kreiff/Cosmic_Loop/Hardware/CL_BOM.xlsx

Part | Qty | Link | Notes
Sanwa OBSF-24 Arcade Buttons (24mm) colors of your choice! | 8 | https://paradisearcadeshop.com/en/home/controls/buttons/buttons-sanwa/sanwa-obsf-24/373_blue-24mm-sanwa-obsf-pushbutton | Any arcade style momentary button is fine - Sanwa is great quality, though
5mm LED | 1 | https://www.mammothelectronics.com/products/wp7113surc-e-5mm-led-red-led
LED Bezel | 1 | https://www.mammothelectronics.com/products/4sledbz5-1
1/4" Mono Enclosed Jack | 2 | https://www.mammothelectronics.com/products/4sjk102m | You don't need to use enclosed jacks, I just prefer them. You can get a Stereo input, but Output is mono via the Shield
4S6500 Enclosure | 1 | https://www.mammothelectronics.com/products/4s6500-enclosure | Any larger hammond style enclosure will do.
10k linear Alpha Single-Gang 12mm Solder Terms | 6 | http://www.smallbear-electronics.mybigcommerce.com/alpha-single-gang-12mm-solder-terms/ | I used 12mm pots - because they are small, but depending on your enclosure you can use bigger ones. Just make sure they are 10k.
Hook-up Wire 22 guage or so | - | https://www.amazon.com/Stranded-different-colored-spools-included/dp/B00B4ZQ3L0/ | You'll probably only need like 12" of wire, but if you DIY, you probably have some
2.2k Resistor | 1 | https://www.mammothelectronics.com/collections/resistors/products/copy-of-1-4-watt-metal-film-resistor-1k-ohms-910k-ohms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 | 1% or 5% tolerance. Just current limiting for the LED.
Arduino Uno | 1 | https://www.amazon.com/gp/product/B008GRTSV6/ref=oh_aui_detailpage_o00_s00?ie=UTF8&psc=1 | Shield works with Due, Mega, and really any other Uno compatible varient
Audio Hacker Shield | 1 | https://nootropicdesign.com/store/product/audio-hacker-kit/ | Kit or assembled.
Center Positive 9V AC/DC adapter (2.1mm barrel) | 1 | https://www.amazon.com/gp/product/B06Y1LF8T5/ref=oh_aui_detailpage_o06_s00?ie=UTF8&psc=1
CR2032 Battery Holder | 1 | https://www.amazon.com/Shapenty-Plastic-Vertical-Battery-Sockets/dp/B071F3HW8J/ | You just need 1 for the project...couldn't find like a $0.25 single anywhere.
CR32 Battery | 1 | https://www.amazon.com/gp/product/B00FO9HQLS/ | same as above...
6 colorful knobs | 6 | http://www.smallbear-electronics.mybigcommerce.com/synth-pointer-2-colors/ | Pots I chose are straight shaft - just make sure you get 1/4" straight shaft if you use the alphas from Small Bear
USB Cable | 1 | https://www.amazon.com/AmazonBasics-USB-2-0-Cable-Male/dp/B00NH11KIK/ | To program the Arduino - if you already have one, you're good.
PCB Standoffs | 4 | https://www.amazon.com/Adhesive-Standoffs-Height-Offset-0-6x0-6/dp/B00QW1QMSU/ | I'm just using these to hold the PCB in place once it's in the case. Neither the Shield or Uno have any kind of mounting hardware on the input side.
Necessary Tools
Drill & bits |  |  | You need to drill the holes for the pots, arcade buttons, Jacks, USB input, etc.
Soldering Iron |  |  | For soldering connections between the buttons, pots, etc.
Solder |  |  | See above
pliers
wire stripper
wire cutters
Nice to have
24mm drill bit / hole saw | 1 | https://www.newegg.com/Product/Product.aspx?Item=9SIAEB47K21703&Tpk=9SIAEB47K21703 | The hole for the Sanwa 24mm buttons needs to be as close as possible to 24mm - the lip on the buttons is pretty shallow - 25mm is actually too big.
Graduated Drill Bit (to 24mm | 1 | https://www.amazon.com/gp/product/B01IEF4666/ | If you don't want a drill bit just for 24mm buttons, a graduated drill bit like this is a good option, but can be hard to work with. Try drilling a pilot hole first and transition to this.
Metal File Set | 1 | https://www.amazon.com/gp/product/B07FJQ9XKG/ | Great for filing burrs as you drill the larger holes. Will also come in handy if you don't have a metal saw or any other way to get square cuts for the USB and DC inlet.
Dremel w/ 1/2" cutting disk | 1 |  | A dremel tool with a small cutting disk would be great for making the USB and DC inlet holes in the enclosure - but not everyone has access to a dremel.
