kreiff/Cosmic_Loop/Comic Loop Manual (Rough).pdf

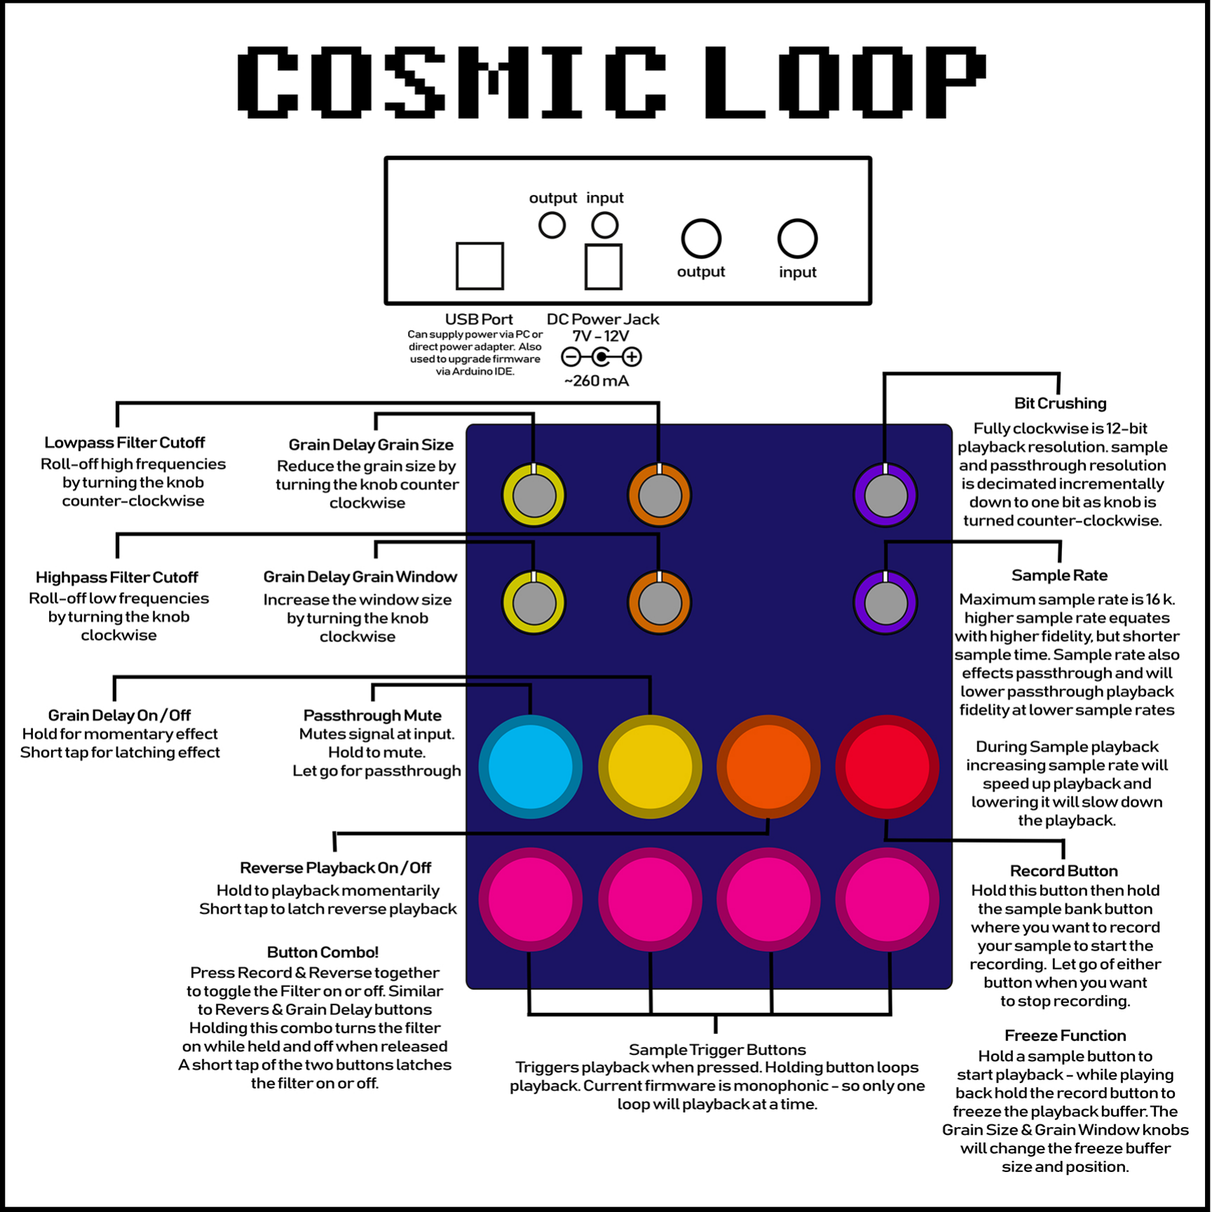
[picture p2: page 1]
