kreiff/Cosmic_Loop/Hardware/CL_Wiring_Diagram (10.21).png

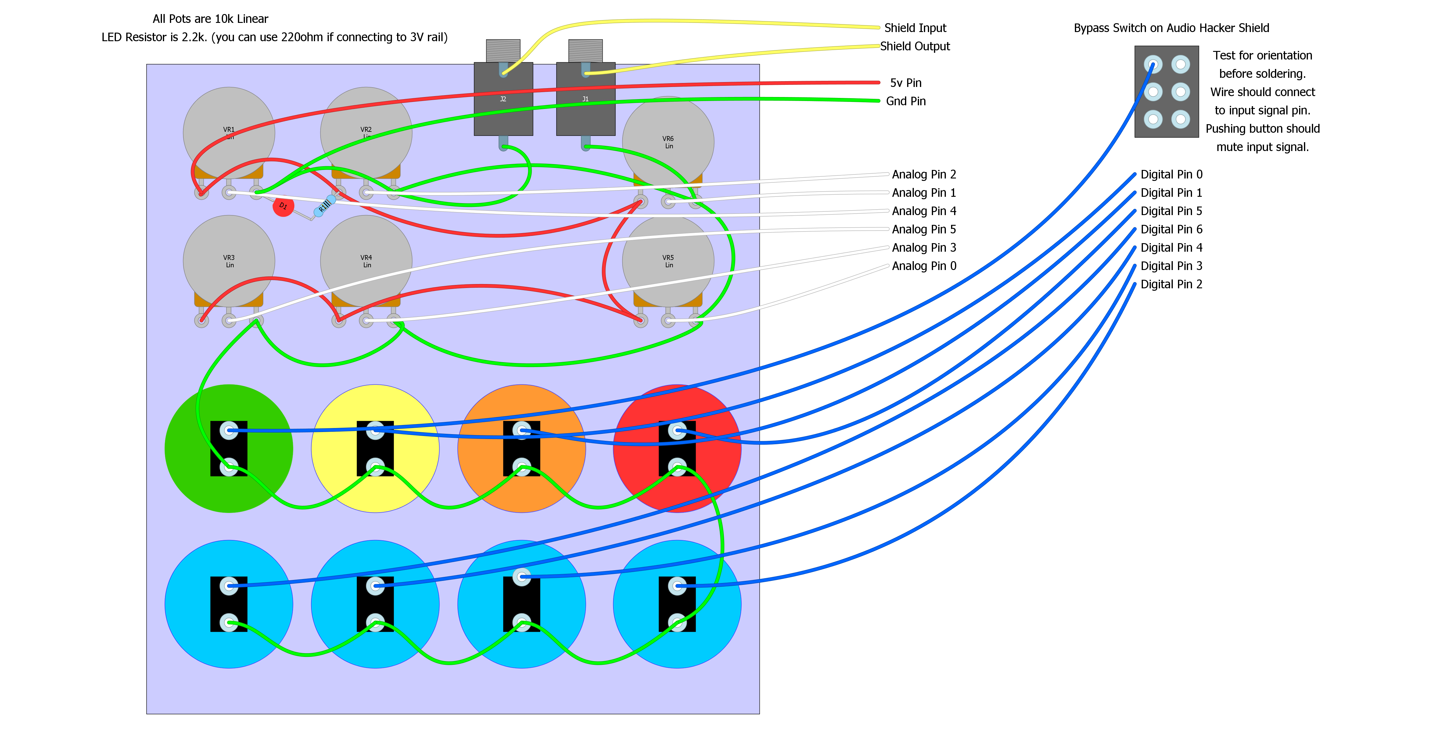
Hardware/CL_Wiring_Diagram (10.21).png
