kreiff/Cosmic_Loop/(commit log)

2018-09-30 Rename MS_speed_bit_crush.ino to Current Build/MS_speed_bit_crush.ino
2018-10-10 Reverse Button Fix, SRT Fix, lowered SRT
2018-10-13 HighPass on Reverse Added, Resonance on Dual Filter Added
2018-10-13 Fixed Reverse UX
    You can now go into reverse mode while a sample is playing by tapping (not holding) the reverse button.
2018-10-14 Updated build w/ Button State Refactor and Better Comments
2018-10-20 Rename CL_10.19_All_Feature_Build.ino to Current Build/CL_10.19_All_Feature_Build.ino
2018-10-21 Updated wiring diagram
    Added wiring for input / passthrough mute and all buttons
2018-10-21 Added Recording Threshold, New comments
    Added a recording threshold for sampling percussive sounds. You can now hold the record button and the record function will not start until the input signal reaches a level slightly above the noise floor. The noise floor for a 12bit A/D is typically around -66db, so the threshold is around -50db or so.
    Added commentary describing the hardwired passthrough mute button.
2018-10-23 BOM Added!
    [CL_BOM.xlsx]
2018-10-24 Current Build For Version 1.0
2018-10-24 Current Build Version 1.0
2018-11-03 Added Filter On/Off via combo button press
2018-11-03 BETA: Freeze Mode Added
    Noted Issue: Toggling the Filter on and off while the buffer is frozen sometimes changes the playback position.
2018-11-18 Added Updated TOP Drill template
2026-04-09 Many long overdue bug fixes
    - Fixed reverse sample implementation - putting the read buffers in the correct order for reverse playback
    - Fixed grain delay implementation - Intra-grain looping was skipped in the v1.2, but added here. Earlier implementation incorrectly advanced through the sample by 3 grains rather than just one.
    - Addressed noise issues native to the ADC by adding some gating on the passthrough symbol when the input signal is below a certain threshold. Allows for much quieter operation at 12-bit playback with no passthrough
    - Added some additional optimizations (Smooth pot/control reads, optional linear interpolation for playback-rate changes, DC blocker (for noise), post-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
    [Cosmic_Loop_v1_11.ino]
2026-04-09 Fixes to freeze mode
    Version 1.11 dropped the scrub function from Freeze mode. This version adds the scrub function back.
    [Cosmic_Loop_v1_13.ino]
