kreiff/Cosmic_Loop/(notices)

Notices in the files:
Current Build/MS_spd_bit_rev_simul (beta).ino:
This program is free software: you can redistribute it and/or modify
it under the terms of the GNU General Public License as published by
the Free Software Foundation, either version 3 of the License, or
(at your option) any later version.
